MatthiasBaill/Linefollower/readme.md

# LineFollower
<br />
<br />
<br />
https://user-images.githubusercontent.com/114672965/206862634-c8b14be8-785b-4b0c-8d98-fc5a53b76b34.jpg
<br />
<br />
  
## specifications
<br />
microcontroller: ATmega32U4 (Arduino Leonardo ETH)
<br />
motors: Micro Metal Gearmotor HP 6V with Extended Motor Shaft 1.6A - 50:1
<br />
h-bridge:DRV8835
<br />
sensors:QTR-8A
<br />
batteries:INR18650-28HE 2800mAh - 10A
<br />
wireless communication:HC-05
<br />
distance sensor - motors: 125 mm
<br />
weight:207g
<br />
speed: 0.657m/s
<br />
