MatthiasBaill/Linefollower/technische tekeningen/elektronisch/Schematic_PCB project_2022-12-23.pdf

## U1HC⁻05

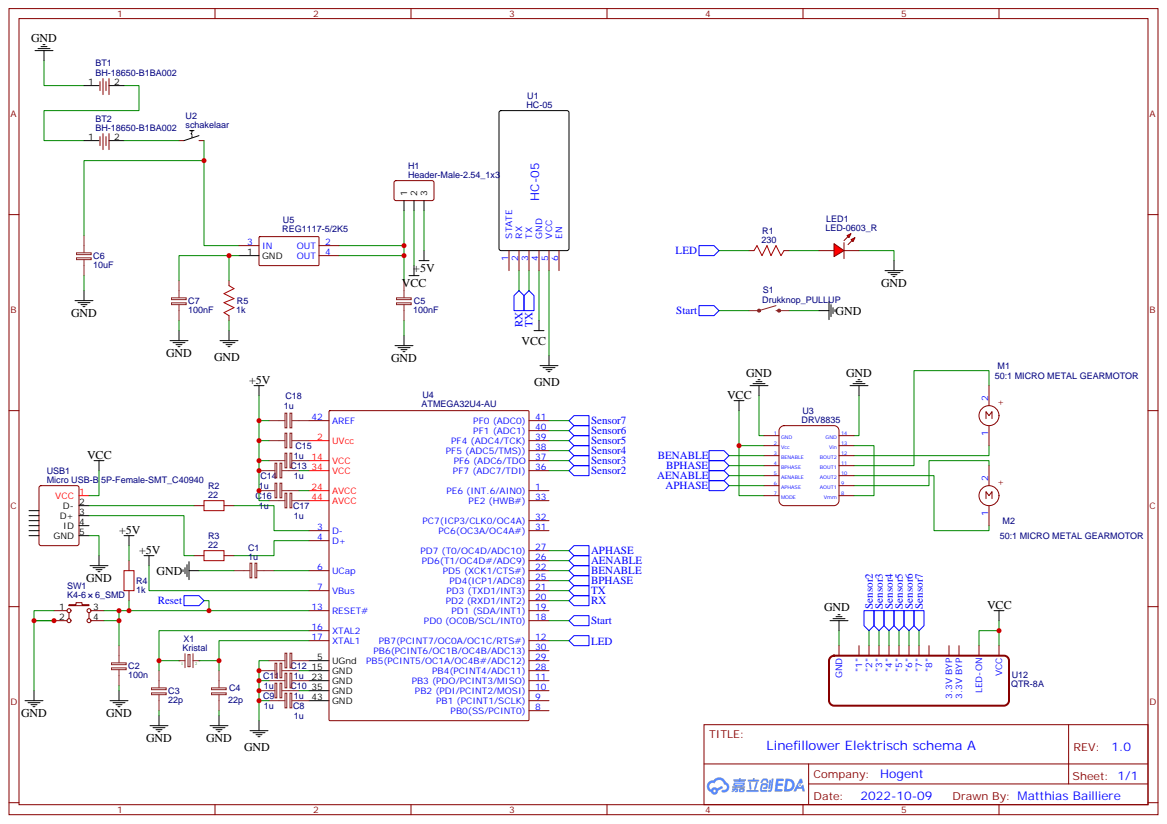
[picture p1: page 1]

PB7(PCINT7/OC0A/OC1C/RTS#) 12
PB2 (PDI/PCINT2/MOSI) 10 PB3 (PDO/PCINT3/MISO) 11 PB4(PCINT4/ADC11) 28 PB5(PCINT5/OC1A/OC4B#/ADC12) 29 PB6(PCINT6/OC1B/OC4B/ADC13) 30

Drawn By: Matthias Bailliere
