MatthiasBaill/Linefollower/code/proof of concepts/interrupt/Interrupts.ino

const int ledPin = 8;
const int interruptPin = 3;
int state = LOW;

void setup() {
  pinMode(ledPin, OUTPUT);
  pinMode(interruptPin, INPUT);
  attachInterrupt(digitalPinToInterrupt(interruptPin), blink, RISING);
}

void loop() {
  digitalWrite(ledPin, state);
}

void blink() {
  state = !state;
}
